sburgic/mouse-jiggler/pcb/mouse-jiggler.kicad_pcb

## KiCad design pcb/mouse-jiggler.kicad_pcb (2026-01-05)

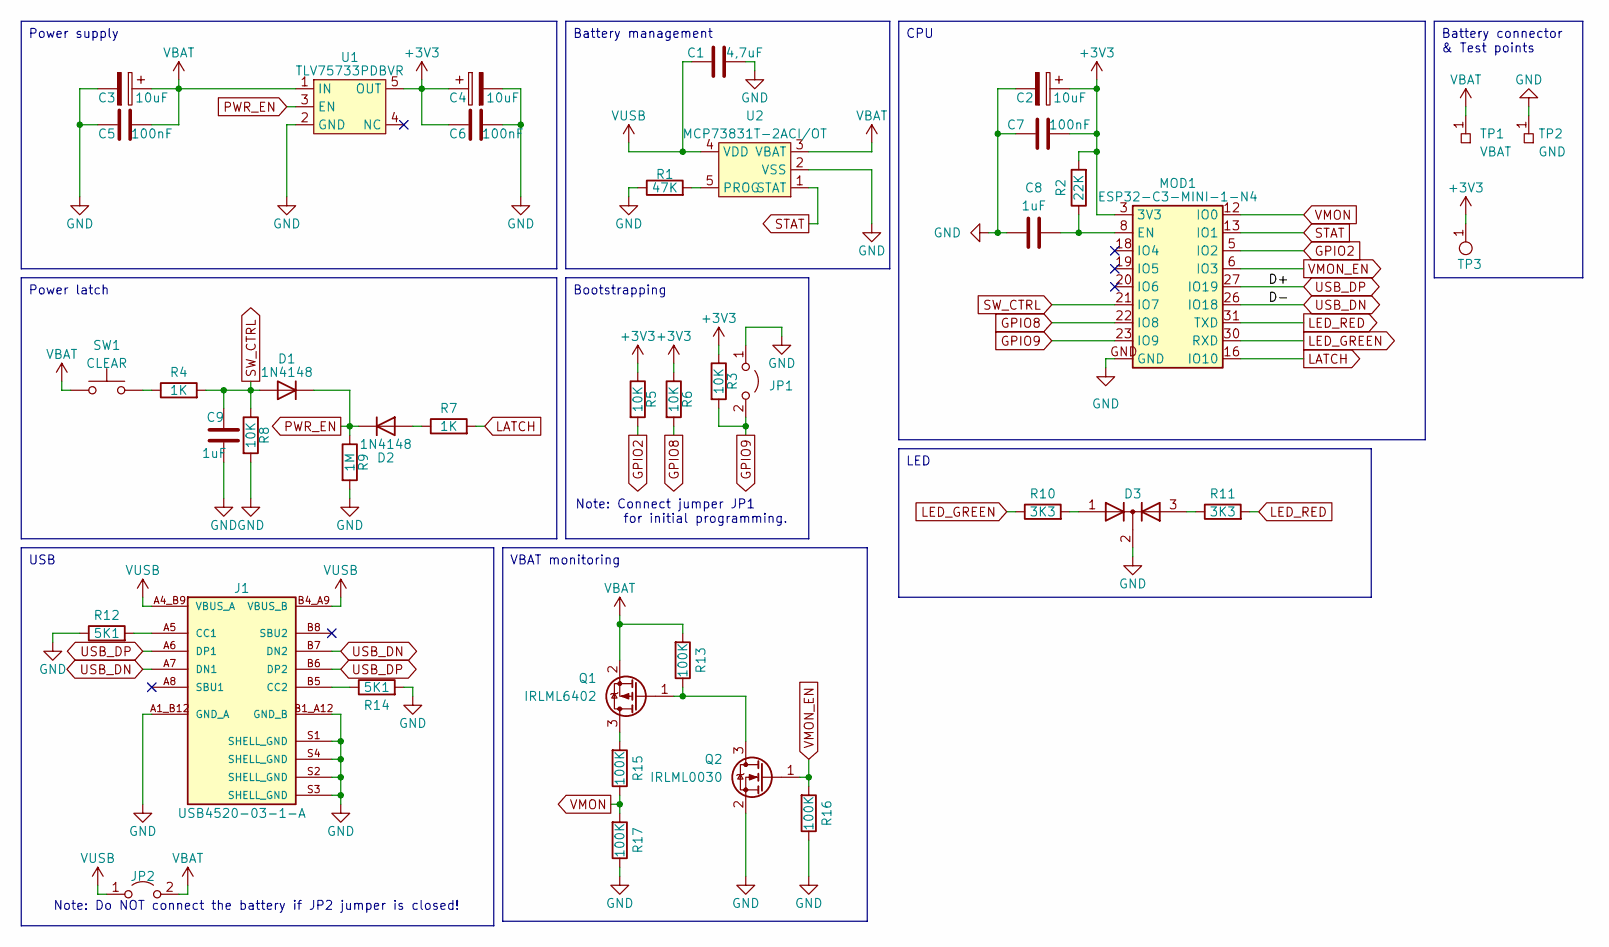
[picture p1: schematic mouse-jiggler.kicad_sch, Mouse Jiggler]

Parts:
C1: 4,7uF; C_0603_1608Metric_Pad1.08x0.95mm_HandSolder
C2, C3, C4: 10uF; C_0603_1608Metric_Pad1.08x0.95mm_HandSolder
C5, C6, C7: 100nF; C_0603_1608Metric_Pad1.08x0.95mm_HandSolder
C8, C9: 1uF; C_0603_1608Metric_Pad1.08x0.95mm_HandSolder
D1, D2: 1N4148; D_SOD-323_HandSoldering
D3: GREEN/RED; TH GENERIC LED 3MM DUAL (RED 3D)
J1: USB4520-03-1-A; SMD USB4520-03-1-A
JP1, JP2: Jumper_2_Open; SolderJumper-2_P1.3mm_Open_RoundedPad1.0x1.5mm
MOD1: ESP32-C3-MINI-1-N4; SMD ESP32-C3-MINI-1-N4
Q1: IRLML6402; SOT-23
Q2: IRLML0030; SOT-23
R1: 47K; R_0603_1608Metric_Pad0.98x0.95mm_HandSolder
R2: 22K; R_0603_1608Metric_Pad0.98x0.95mm_HandSolder
R3, R5, R6, R8: 10K; R_0603_1608Metric_Pad0.98x0.95mm_HandSolder
R4, R7: 1K; R_0603_1608Metric_Pad0.98x0.95mm_HandSolder
R9: 1M; R_0603_1608Metric_Pad0.98x0.95mm_HandSolder
R10, R11: 3K3; R_0603_1608Metric_Pad0.98x0.95mm_HandSolder
R12, R14: 5K1; R_0603_1608Metric_Pad0.98x0.95mm_HandSolder
R13, R15, R16, R17: 100K; R_0603_1608Metric_Pad0.98x0.95mm_HandSolder
SW1: CLEAR; SMD GENERIC 2-PIN 3.6x6x2.5
TP1: VBAT; TestPoint_THTPad_1.5x1.5mm_Drill0.7mm
TP2: GND; TestPoint_THTPad_1.5x1.5mm_Drill0.7mm
TP3: TP-ROUND-SMD-2MM; TestPoint_Pad_D1.0mm
U1: TLV75733PDBVR; SOT-23-5_HandSoldering
U2: MCP73831T-2ACI/OT; TSOP-5_1.65x3.05mm_P0.95mm

Connections:
+3V3: C2.1, C4.1, C6.2, C7.1, MOD1.3 (3V3), R2.2, R3.1, R5.1, R6.1, TP3.1, U1.5 (OUT)
GND: C1.2, C2.2, C3.2, C4.2, C5.1, C6.1, C7.2, C8.1, C9.2, D3.2 (K), J1.A1_B12 (GND_A), J1.B1_A12 (GND_B), J1.S1 (SHELL_GND), J1.S2 (SHELL_GND), J1.S3 (SHELL_GND), J1.S4 (SHELL_GND), JP1.1 (A), MOD1.GND, Q2.2 (S), R1.1, R8.2, R9.2, R12.1, R14.2, R16.1, R17.1, TP2.1, U1.2 (GND), U2.2 (VSS)
GPIO2: MOD1.5 (IO2), R5.2
GPIO8: MOD1.22 (IO8), R6.2
GPIO9: JP1.2 (B), MOD1.23 (IO9), R3.2
LATCH: MOD1.16 (IO10), R7.2
LED_GREEN: MOD1.30 (RXD), R10.1
LED_RED: MOD1.31 (TXD), R11.2
unnamed: D2.2 (A), R7.1
unnamed: D3.1 (A), R10.2
unnamed: D3.3 (A), R11.1
unnamed: J1.A5 (CC1), R12.2
unnamed: J1.B5 (CC2), R14.1
unnamed: C8.2, MOD1.8 (EN), R2.1
unnamed: Q1.3 (D), R15.2
unnamed: Q1.1 (G), Q2.3 (D), R13.1
unnamed: R4.1, SW1.1
unnamed: R1.2, U2.5 (PROG)
PWR_EN: D1.1 (K), D2.1 (K), R9.1, U1.3 (EN)
STAT: MOD1.13 (IO1), U2.1 (STAT)
SW_CTRL: C9.1, D1.2 (A), MOD1.21 (IO7), R4.2, R8.1
USB_DN: J1.A7 (DN1), J1.B7 (DN2), MOD1.26 (IO18)
USB_DP: J1.A6 (DP1), J1.B6 (DP2), MOD1.27 (IO19)
VBAT: C3.1, C5.2, JP2.2 (B), Q1.2 (S), R13.2, SW1.2, TP1.1, U1.1 (IN), U2.3 (VBAT)
VMON: MOD1.12 (IO0), R15.1, R17.2
VMON_EN: MOD1.6 (IO3), Q2.1 (G), R16.2
VUSB: C1.1, J1.A4_B9 (VBUS_A), J1.B4_A9 (VBUS_B), JP2.1 (A), U2.4 (VDD)

Notes on the sheet:
Note: Do NOT connect the battery if JP2 jumper is closed!
Note: Connect jumper JP1 for initial programming.
Battery connector & Test points
Battery management
CPU
Power latch
VBAT monitoring
Bootstrapping
Power supply
USB
LED

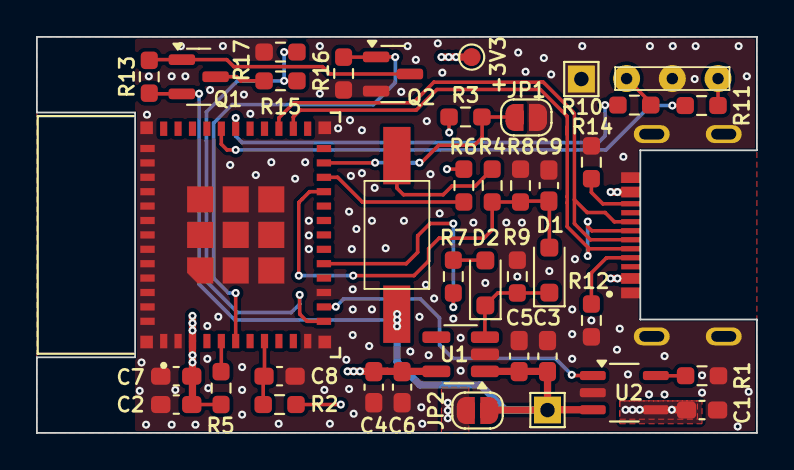
[picture p2: board mouse-jiggler.kicad_pcb from above]

Board: 4 copper layers, 40.0 x 22.0 mm, 41 parts (0 on the bottom side), 27 nets.
